mcmaier/hodor/hodor_hardware/mechanics/TSM-104-01-L-SH--3DModel-STEP-56544.STEP

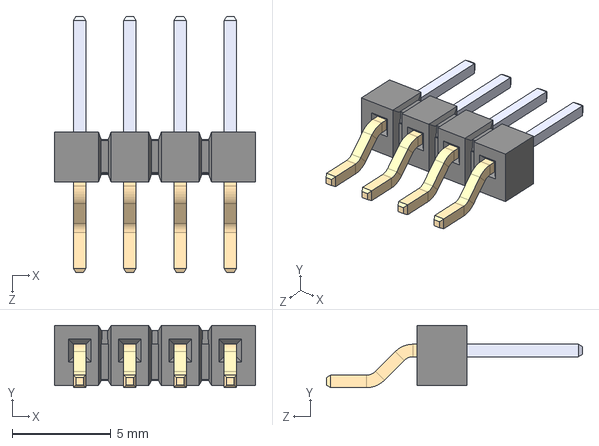
[picture p1: CAD file, 2025-02-26, last stored version]
hodor_hardware/mechanics/TSM-104-01-L-SH--3DModel-STEP-56544.STEP
10.2 x 3.15 x 13.0 mm
