mcmaier/hodor/hodor_hardware/mechanics/SSD1306_OLED.step

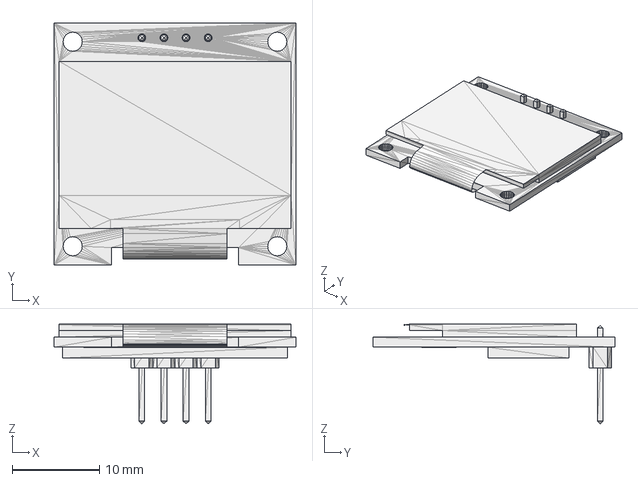
[picture p2: CAD file, 2025-02-26, last stored version]
hodor_hardware/mechanics/SSD1306_OLED.step
27.8 x 27.8 x 11.4 mm
