mcmaier/hodor/hodor_hardware/mechanics/449-340-55.STEP

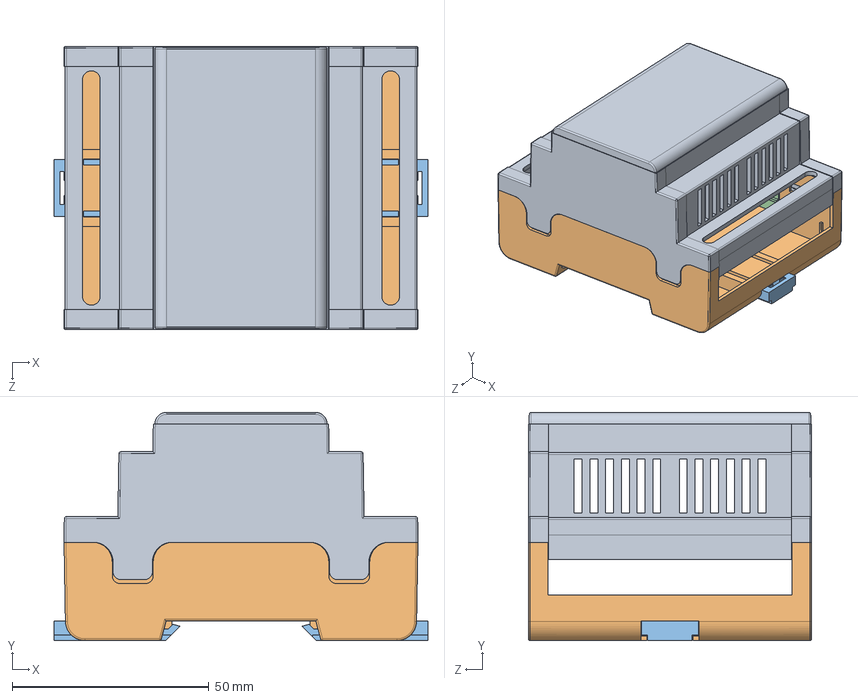
[picture p3: CAD file, 2025-02-26, last stored version]
hodor_hardware/mechanics/449-340-55.STEP
95.0 x 58.0 x 72.0 mm
044934056s
044934011s
044900300s x 2
044900400s x 2
