mcmaier/hodor/hodor_hardware/mechanics/SMH-104-02-G-S.stp

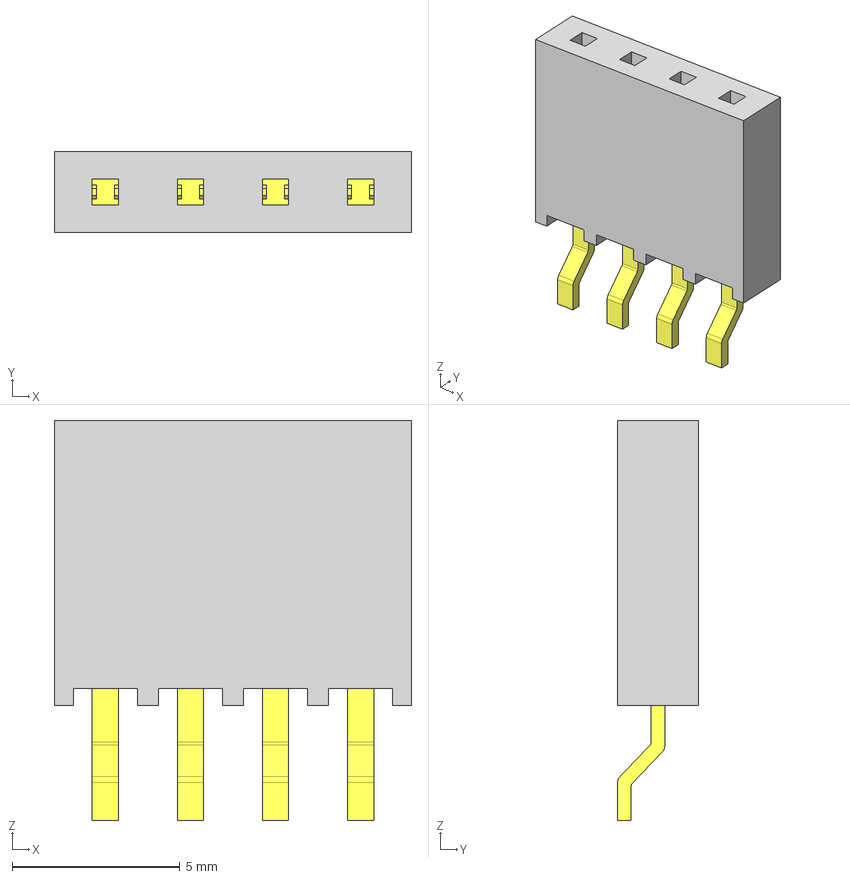
[picture p4: CAD file, 2025-02-26, last stored version]
hodor_hardware/mechanics/SMH-104-02-G-S.stp
10.7 x 2.41 x 11.9 mm
SMH-104-S_socket
C-08-03-04-S_SMH
