mcmaier/hodor/hodor_hardware/mechanics/apra_Rail_DB4.DXF

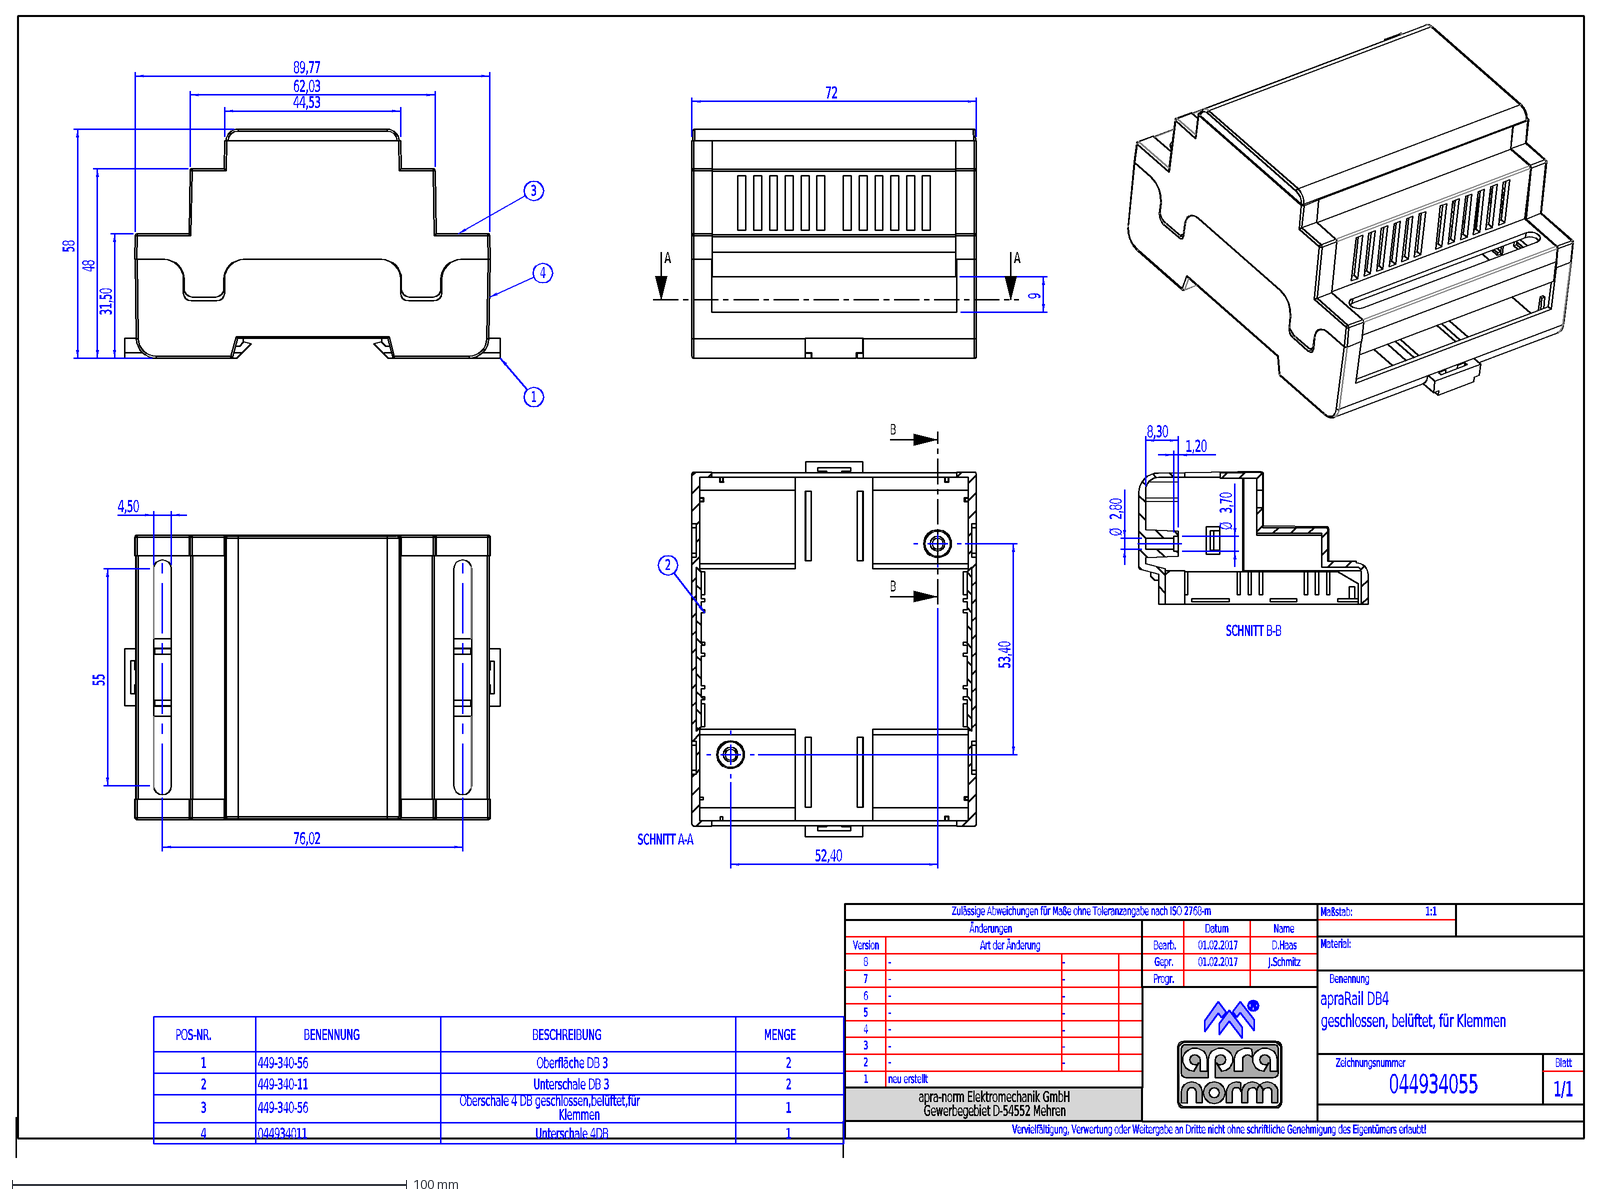
[picture p5: CAD file, 2025-02-26, last stored version]
hodor_hardware/mechanics/apra_Rail_DB4.DXF
-
1/1
044934055
geschlossen, belüftet, für Klemmen
apraRail DB4
01.02.2017
D.Haas
J.Schmitz
neu erstellt
Vervielfältigung, Verwertung oder Weitergabe an Dritte nicht ohne schriftliche Genehmigung des Eigentümers erlaubt!
Maßstab:
Material:
Benennung
Zeichnungsnummer
Blatt
Zulässige Abweichungen für Maße ohne Toleranzangabe nach ISO 2768-m
Name
Datum
Bearb.
Gepr.
Progr.
Änderungen
Art der Änderung
Version
8
7
4
5
6
1
2
3
apra-norm Elektromechanik GmbH
Gewerbegebiet D-54552 Mehren
1:1
POS-NR.
BENENNUNG
BESCHREIBUNG
MENGE
449-340-56
Oberfläche DB 3
449-340-11
Unterschale DB 3
Oberschale 4 DB geschlossen,belüftet,für
Klemmen
044934011
Unterschale 4DB
89,77
62,03
44,53
31,50
48
58
72
9
A
4,50
55
76,02
52,40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
