mcmaier/hodor/hodor_hardware/hodor_hardware.kicad_pcb

## KiCad design hodor_hardware/hodor_hardware.kicad_pcb (2025-03-13, last stored version)

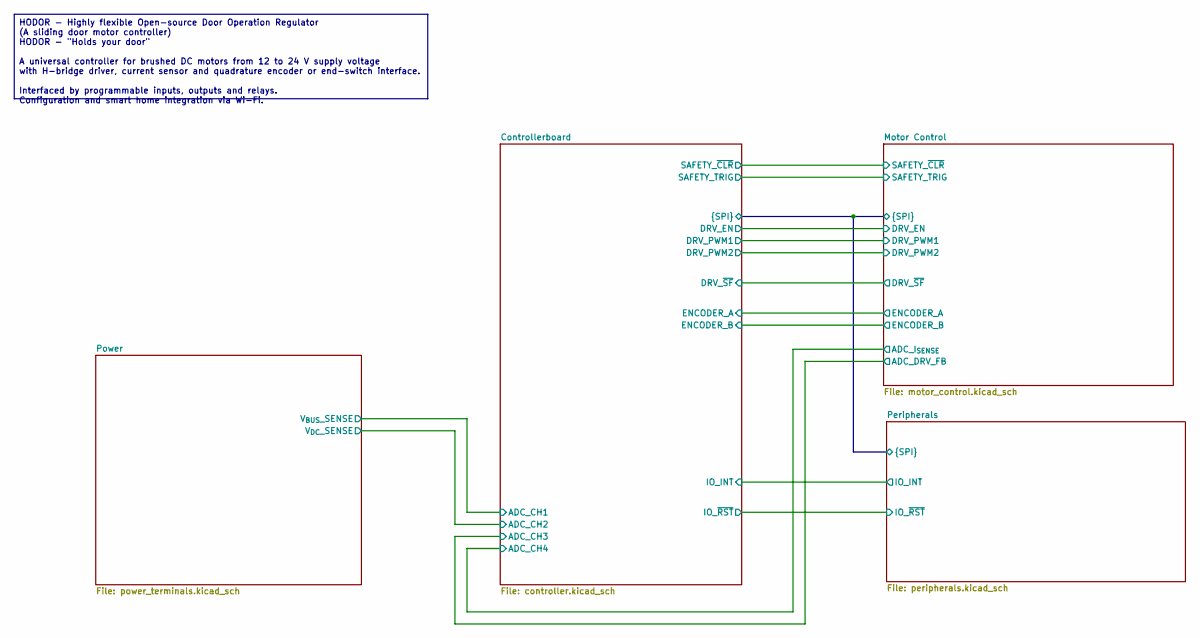
[picture p6: schematic hodor_hardware.kicad_sch, HODOR (Highly flexible Open-source Door Operation Regulator)]

Notes on the sheet:
HODOR - Highly flexible Open-source Door Operation Regulator (A sliding door motor controller) HODOR - "Holds your door" A universal controller for brushed DC motors from 12 to 24 V supply voltage with H-bridge driver, current sensor and quadrature encoder or end-switch interface. Interfaced by pro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

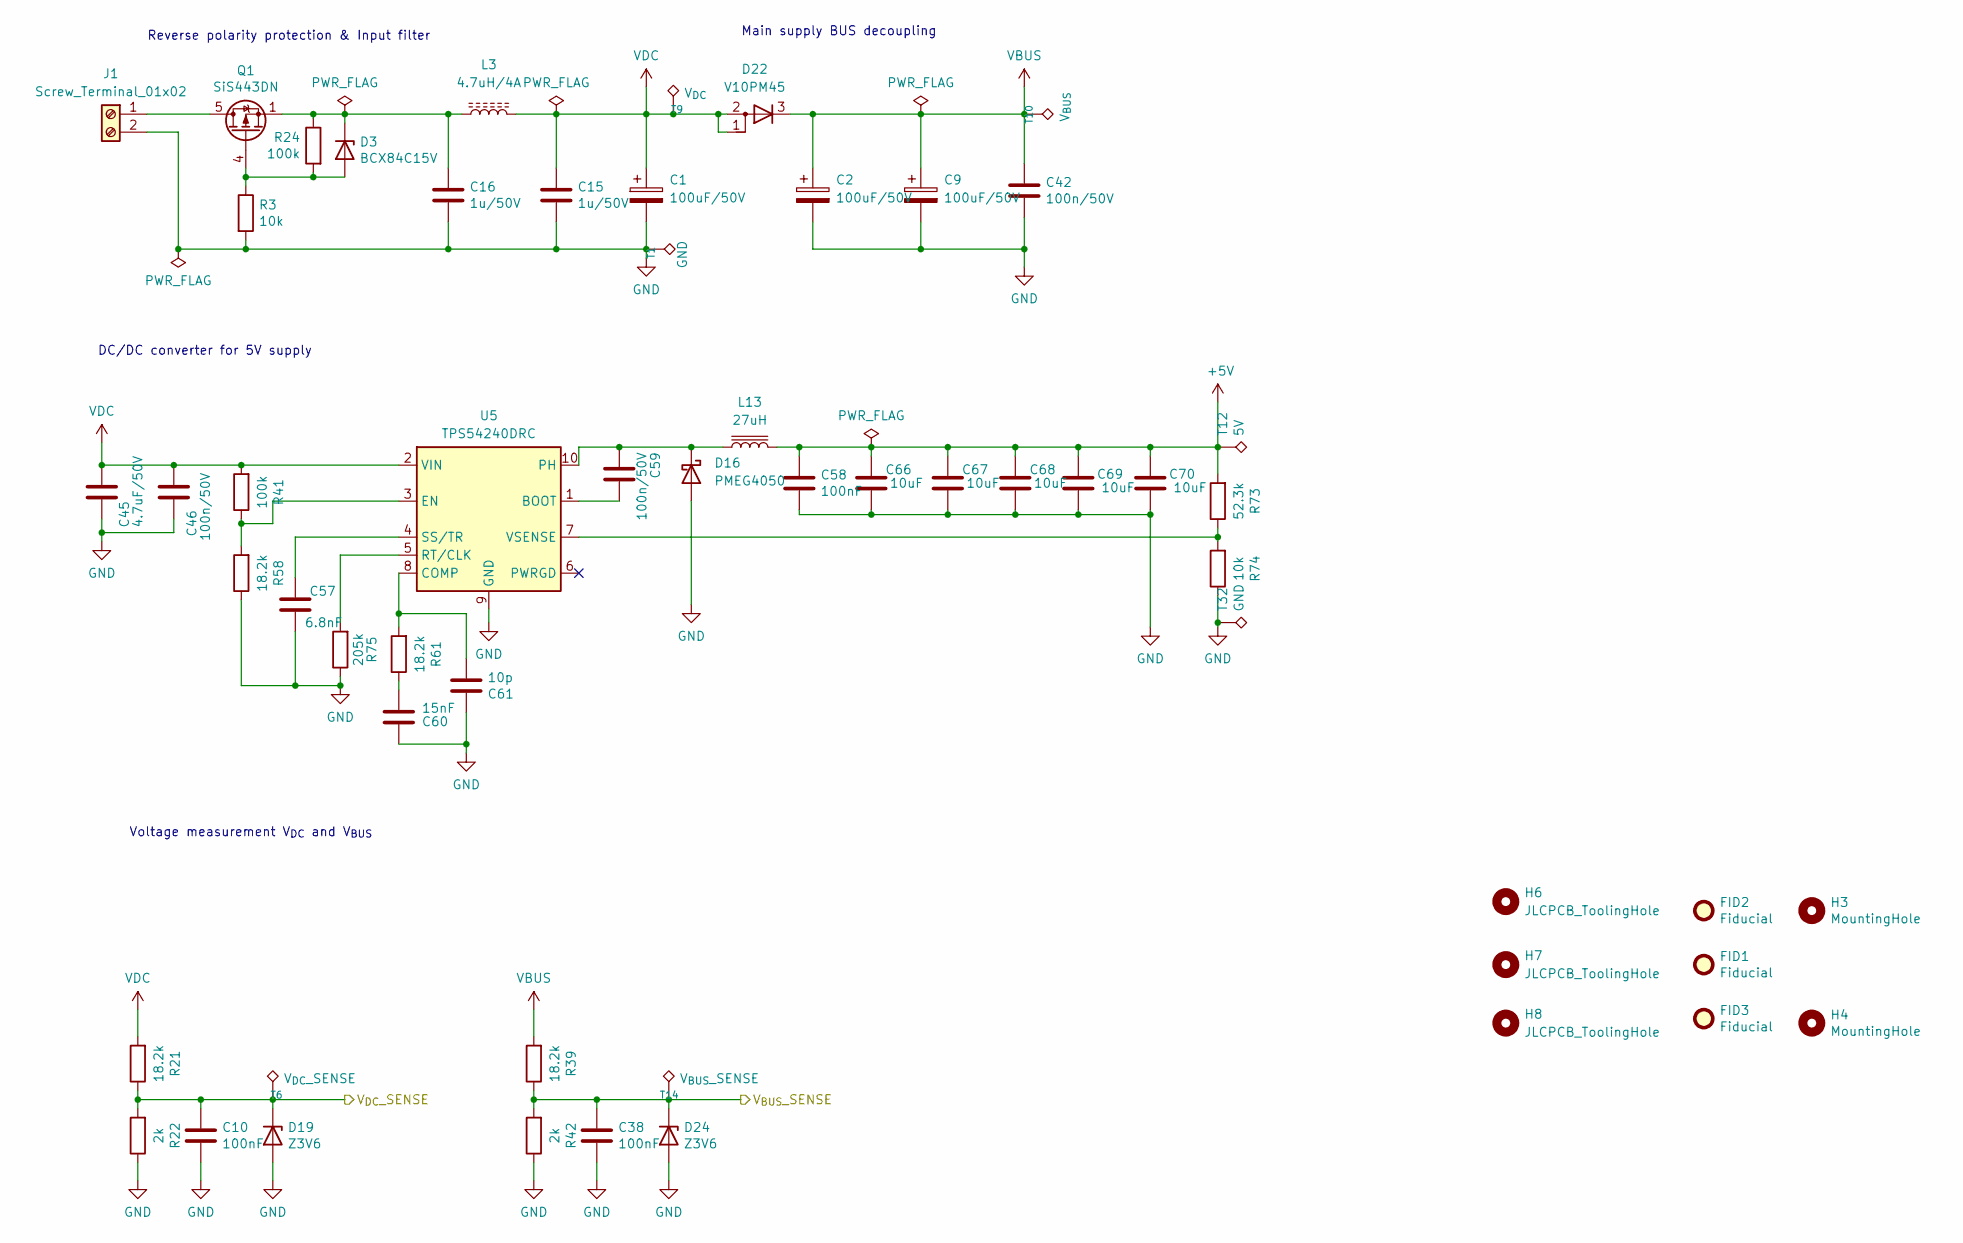
[picture p7: schematic power_terminals.kicad_sch, HODOR (Highly flexible Open-source Door Operation Regulator)]

Parts:
C1, C2, C9: 100uF/50V; C_Elec_8x10.2
C10, C38, C58: 100nF; C_0402_1005Metric
C15, C16: 1u/50V; C_0805_2012Metric
C42, C46, C59: 100n/50V; C_0603_1608Metric
C45: 4.7uF/50V; C_1206_3216Metric
C57: 6.8nF; C_0402_1005Metric
C60: 15nF; C_0402_1005Metric
C61: 10p; C_0402_1005Metric
C66, C67, C68, C69, C70: 10uF; C_0805_2012Metric
D3: BCX84C15V; D_SOD-523
D16: PMEG4050; D_SMB
D19, D24: Z3V6; D_SOD-523
D22: V10PM45; TO-277A
FID1, FID2, FID3: Fiducial; Fiducial_1mm_Mask2mm
H3, H4: MountingHole; MountingHole_3.2mm_M3
H6, H7, H8: JLCPCB_ToolingHole
J1: Screw_Terminal_01x02; TerminalBlock_Phoenix_MKDS-1,5-2_1x02_P5.00mm_Horizontal
L3: 4.7uH/4A; L_Wuerth_MAPI-4020
L13: 27uH; L_Wuerth_WE-PD-Typ-7345
Q1: SiS443DN; Vishay_PowerPAK_1212-8_Single
R3, R74: 10k; R_0402_1005Metric
R21, R39, R58, R61: 18.2k; R_0402_1005Metric
R22, R42: 2k; R_0402_1005Metric
R24, R41: 100k; R_0402_1005Metric
R73: 52.3k; R_0402_1005Metric
R75: 205k; R_0402_1005Metric
T1, T32: GND; TestPoint_Pad_1.0x1.0mm
T6: V_{DC}_SENSE; TestPoint_Pad_D1.0mm
T9: V_{DC}; TestPoint_Pad_D1.0mm
T10: V_{BUS}; TestPoint_Pad_D1.0mm
T12: 5V; TestPoint_Pad_D1.0mm
T14: V_{BUS}_SENSE; TestPoint_Pad_D1.0mm
U5: TPS54240DRC; Texas_DRC0010J_ThermalVias

Connections:
+5V: C58.1, C66.1, C67.1, C68.1, C69.1, C70.1, L13.2, R73.2, T12.1; also elsewhere on the board
/Controllerboard/ADC_CH1: C38.1, D24.1 (K), R39.1, R42.2, T14.1; also elsewhere on the board
/Controllerboard/ADC_CH2: C10.1, D19.1 (K), R21.1, R22.2, T6.1; also elsewhere on the board
GND: C1.2, C2.2, C9.2, C10.2, C15.2, C16.2, C38.2, C42.2, C45.2, C46.2, C57.2, C58.2, C60.1, C61.1, C66.2, C67.2, C68.2, C69.2, C70.2, D16.2 (A), D19.2 (A), D24.2 (A), J1.2, R3.2, R22.1, R42.1, R58.1, R74.1, R75.1, T1.1, T32.1, U5.9 (GND), U5.11 (GND); also elsewhere on the board
unnamed: C60.2, R61.1
unnamed: D3.2 (A), Q1.4 (G), R3.1, R24.2
unnamed: C16.1, D3.1 (K), L3.1, Q1.1 (S), Q1.2 (S), Q1.3 (S), R24.1
unnamed: C59.2, D16.1 (K), L13.1, U5.10 (PH)
unnamed: J1.1, Q1.5 (D)
unnamed: C59.1, U5.1 (BOOT)
unnamed: C61.2, R61.2, U5.8 (COMP)
unnamed: R41.1, R58.2, U5.3 (EN)
unnamed: R75.2, U5.5 (RT/CLK)
unnamed: C57.1, U5.4 (SS/TR)
unnamed: R73.1, R74.2, U5.7 (VSENSE)
VBUS: C2.1, C9.1, C42.1, D22.3 (K), R39.2, T10.1; also elsewhere on the board
VDC: C1.1, C15.1, C45.1, C46.1, D22.1 (A), D22.2 (A), L3.2, R21.2, R41.2, T9.1, U5.2 (VIN); also elsewhere on the board

Notes on the sheet:
DC/DC converter for 5V supply
Voltage measurement V_{DC} and V_{BUS}
Reverse polarity protection & Input filter
Main supply BUS decoupling

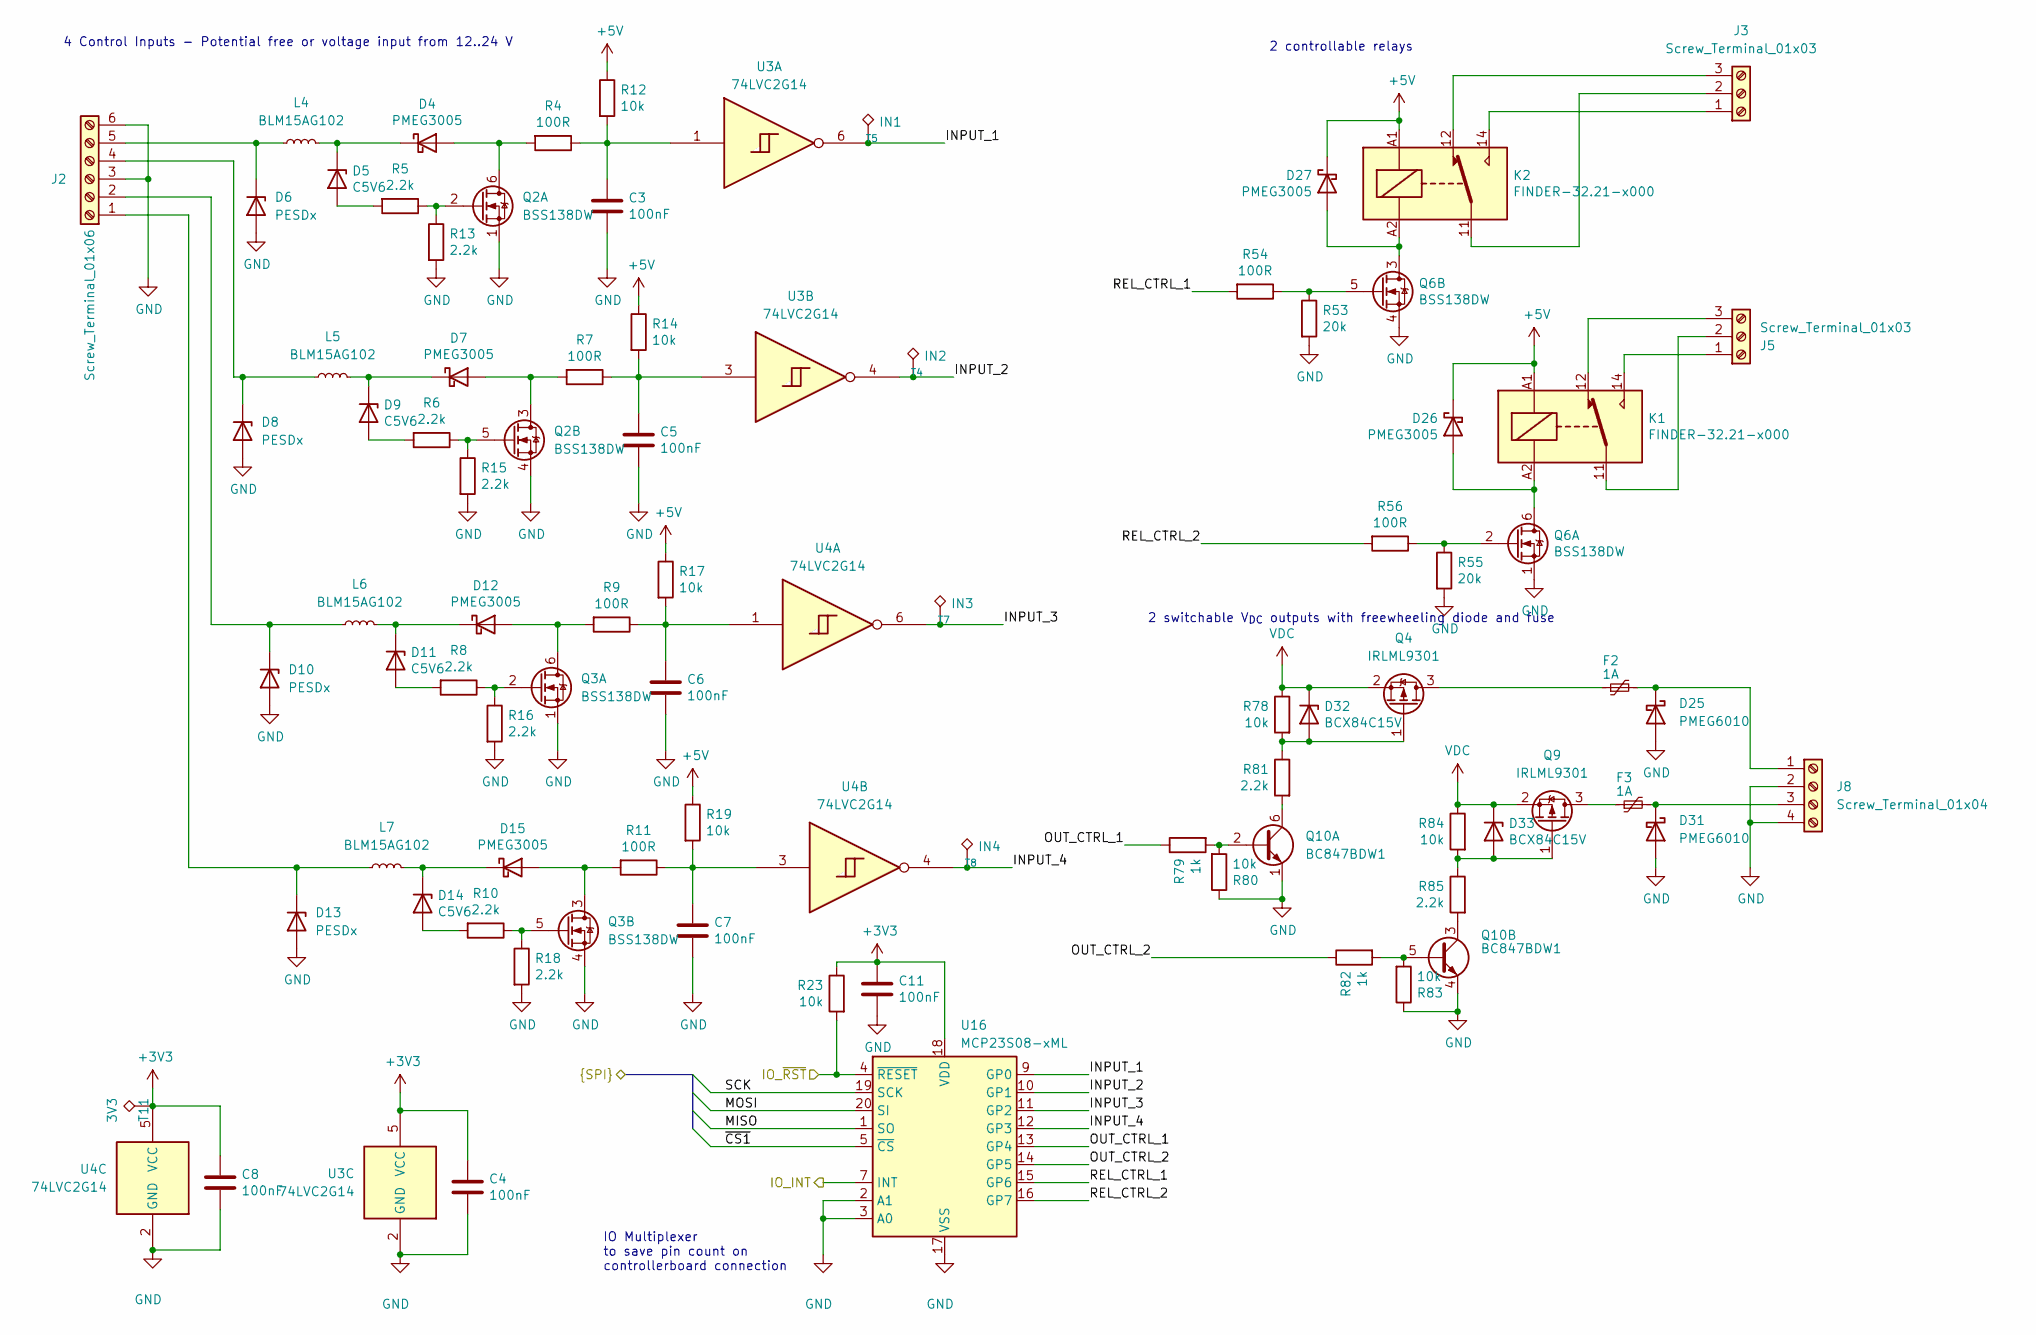
[picture p8: schematic peripherals.kicad_sch, HODOR (Highly flexible Open-source Door Operation Regulator)]

Parts:
C3, C4, C5, C6, C7, C8, C11: 100nF; C_0402_1005Metric
D4, D7, D12, D15, D26, D27: PMEG3005; D_SOD-523
D5, D9, D11, D14: C5V6; D_SOD-523
D6, D8, D10, D13: PESDx; D_SOD-523
D25, D31: PMEG6010; D_SOD-123F
D32, D33: BCX84C15V; D_SOD-523
F2, F3: 1A; Fuse_1210_3225Metric
J2: Screw_Terminal_01x06; TerminalBlock_Phoenix_MKDS-1,5-6_1x06_P5.00mm_Horizontal
J3, J5: Screw_Terminal_01x03; TerminalBlock_Phoenix_MKDS-1,5-3_1x03_P5.00mm_Horizontal
J8: Screw_Terminal_01x04; TerminalBlock_Phoenix_MKDS-1,5-4_1x04_P5.00mm_Horizontal
K1, K2: FINDER-32.21-x000; Relay_SPDT_Finder_32.21-x000
L4, L5, L6, L7: BLM15AG102; L_0402_1005Metric
Q2, Q3, Q6: BSS138DW; SOT-363_SC-70-6
Q4, Q9: IRLML9301; SOT-23
Q10: BC847BDW1; SOT-363_SC-70-6
R4, R7, R9, R11, R54, R56: 100R; R_0402_1005Metric
R5, R6, R8, R10, R13, R15, R16, R18, R81, R85: 2.2k; R_0402_1005Metric
R12, R14, R17, R19, R23, R78, R80, R83, R84: 10k; R_0402_1005Metric
R53, R55: 20k; R_0402_1005Metric
R79, R82: 1k; R_0402_1005Metric
T4: IN2; TestPoint_Pad_D1.0mm
T5: IN1; TestPoint_Pad_D1.0mm
T7: IN3; TestPoint_Pad_D1.0mm
T8: IN4; TestPoint_Pad_D1.0mm
T11: 3V3; TestPoint_Pad_D1.0mm
U3, U4: 74LVC2G14; SOT-23-6
U16: MCP23S08-xML; QFN-20-1EP_4x4mm_P0.5mm_EP2.7x2.7mm

Connections:
+3V3: C4.1, C8.1, C11.1, R23.1, T11.1, U3.5 (VCC), U4.5 (VCC), U16.18 (VDD); also elsewhere on the board
+5V: D26.1 (K), D27.1 (K), K1.A1, K2.A1, R12.1, R14.1, R17.1, R19.1; also elsewhere on the board
/Controllerboard/IO_INT: U16.7 (INT); also elsewhere on the board
/Controllerboard/IO_~RST: R23.2, U16.4 (~RESET); also elsewhere on the board
/Controllerboard/MISO: U16.1 (SO); also elsewhere on the board
/Controllerboard/MOSI: U16.20 (SI); also elsewhere on the board
/Controllerboard/SCK: U16.19 (SCK); also elsewhere on the board
/Controllerboard/~CS1: U16.5 (~CS); also elsewhere on the board
/Peripherals/INPUT_1: T5.1, U3.6, U16.9 (GP0)
/Peripherals/INPUT_2: T4.1, U3.4, U16.10 (GP1)
/Peripherals/INPUT_3: T7.1, U4.6, U16.11 (GP2)
/Peripherals/INPUT_4: T8.1, U4.4, U16.12 (GP3)
/Peripherals/OUT_CTRL_1: R79.1, U16.13 (GP4)
/Peripherals/OUT_CTRL_2: R82.1, U16.14 (GP5)
/Peripherals/REL_CTRL_1: R54.2, U16.15 (GP6)
/Peripherals/REL_CTRL_2: R56.2, U16.16 (GP7)
GND: C3.2, C4.2, C5.2, C6.2, C7.2, C8.2, C11.2, D6.2 (A), D8.2 (A), D10.2 (A), D13.2 (A), D25.2 (A), D31.2 (A), J2.3, J2.6, J8.2, J8.4, Q2.1 (S), Q2.4 (S), Q3.1 (S), Q3.4 (S), Q6.1 (S), Q6.4 (S), Q10.1 (E1), Q10.4 (E2), R13.2, R15.2, R16.2, R18.2, R53.2, R55.2, R80.1, R83.1, U3.2 (GND), U4.2 (GND), U16.2 (A1), U16.3 (A0), U16.17 (VSS); also elsewhere on the board
unnamed: C3.1, R4.1, R12.2, U3.1
unnamed: C5.1, R7.1, R14.2, U3.3
unnamed: C6.1, R9.1, R17.2, U4.1
unnamed: C7.1, R11.1, R19.2, U4.3
unnamed: D4.2 (A), Q2.6 (D), R4.2
unnamed: D4.1 (K), D5.1 (K), L4.2
unnamed: D5.2 (A), R5.2
unnamed: D6.1 (K), J2.5, L4.1
unnamed: D7.2 (A), Q2.3 (D), R7.2
unnamed: D7.1 (K), D9.1 (K), L5.2
unnamed: D8.1 (K), J2.4, L5.1
unnamed: D9.2 (A), R6.2
unnamed: D10.1 (K), J2.2, L6.1
unnamed: D11.2 (A), R8.2
unnamed: D11.1 (K), D12.1 (K), L6.2
unnamed: D12.2 (A), Q3.6 (D), R9.2
unnamed: D13.1 (K), J2.1, L7.1
unnamed: D14.2 (A), R10.2
unnamed: D14.1 (K), D15.1 (K), L7.2
unnamed: D15.2 (A), Q3.3 (D), R11.2
unnamed: D25.1 (K), F2.2, J8.1
unnamed: D26.2 (A), K1.A2, Q6.6 (D)
unnamed: D27.2 (A), K2.A2, Q6.3 (D)
unnamed: D31.1 (K), F3.2, J8.3
unnamed: D32.2 (A), Q4.1 (G), R78.2, R81.1
unnamed: D33.2 (A), Q9.1 (G), R84.2, R85.1
unnamed: J3.1, K2.14
unnamed: J3.2, K2.11
unnamed: J3.3, K2.12
unnamed: J5.1, K1.14
unnamed: J5.2, K1.11
unnamed: J5.3, K1.12
unnamed: Q2.2 (G), R5.1, R13.1
unnamed: Q2.5 (G), R6.1, R15.1
unnamed: Q3.2 (G), R8.1, R16.1
unnamed: Q3.5 (G), R10.1, R18.1
unnamed: F2.1, Q4.3 (D)
unnamed: Q6.2 (G), R55.1, R56.1
unnamed: Q6.5 (G), R53.1, R54.1
unnamed: F3.1, Q9.3 (D)
unnamed: Q10.2 (B1), R79.2, R80.2
unnamed: Q10.6 (C1), R81.2
unnamed: Q10.5 (B2), R82.2, R83.2
unnamed: Q10.3 (C2), R85.2
VDC: D32.1 (K), D33.1 (K), Q4.2 (S), Q9.2 (S), R78.1, R84.1; also elsewhere on the board

Notes on the sheet:
4 Control Inputs - Potential free or voltage input from 12..24 V
2 controllable relays
2 switchable V_{DC} outputs with freewheeling diode and fuse
IO Multiplexer to save pin count on controllerboard connection

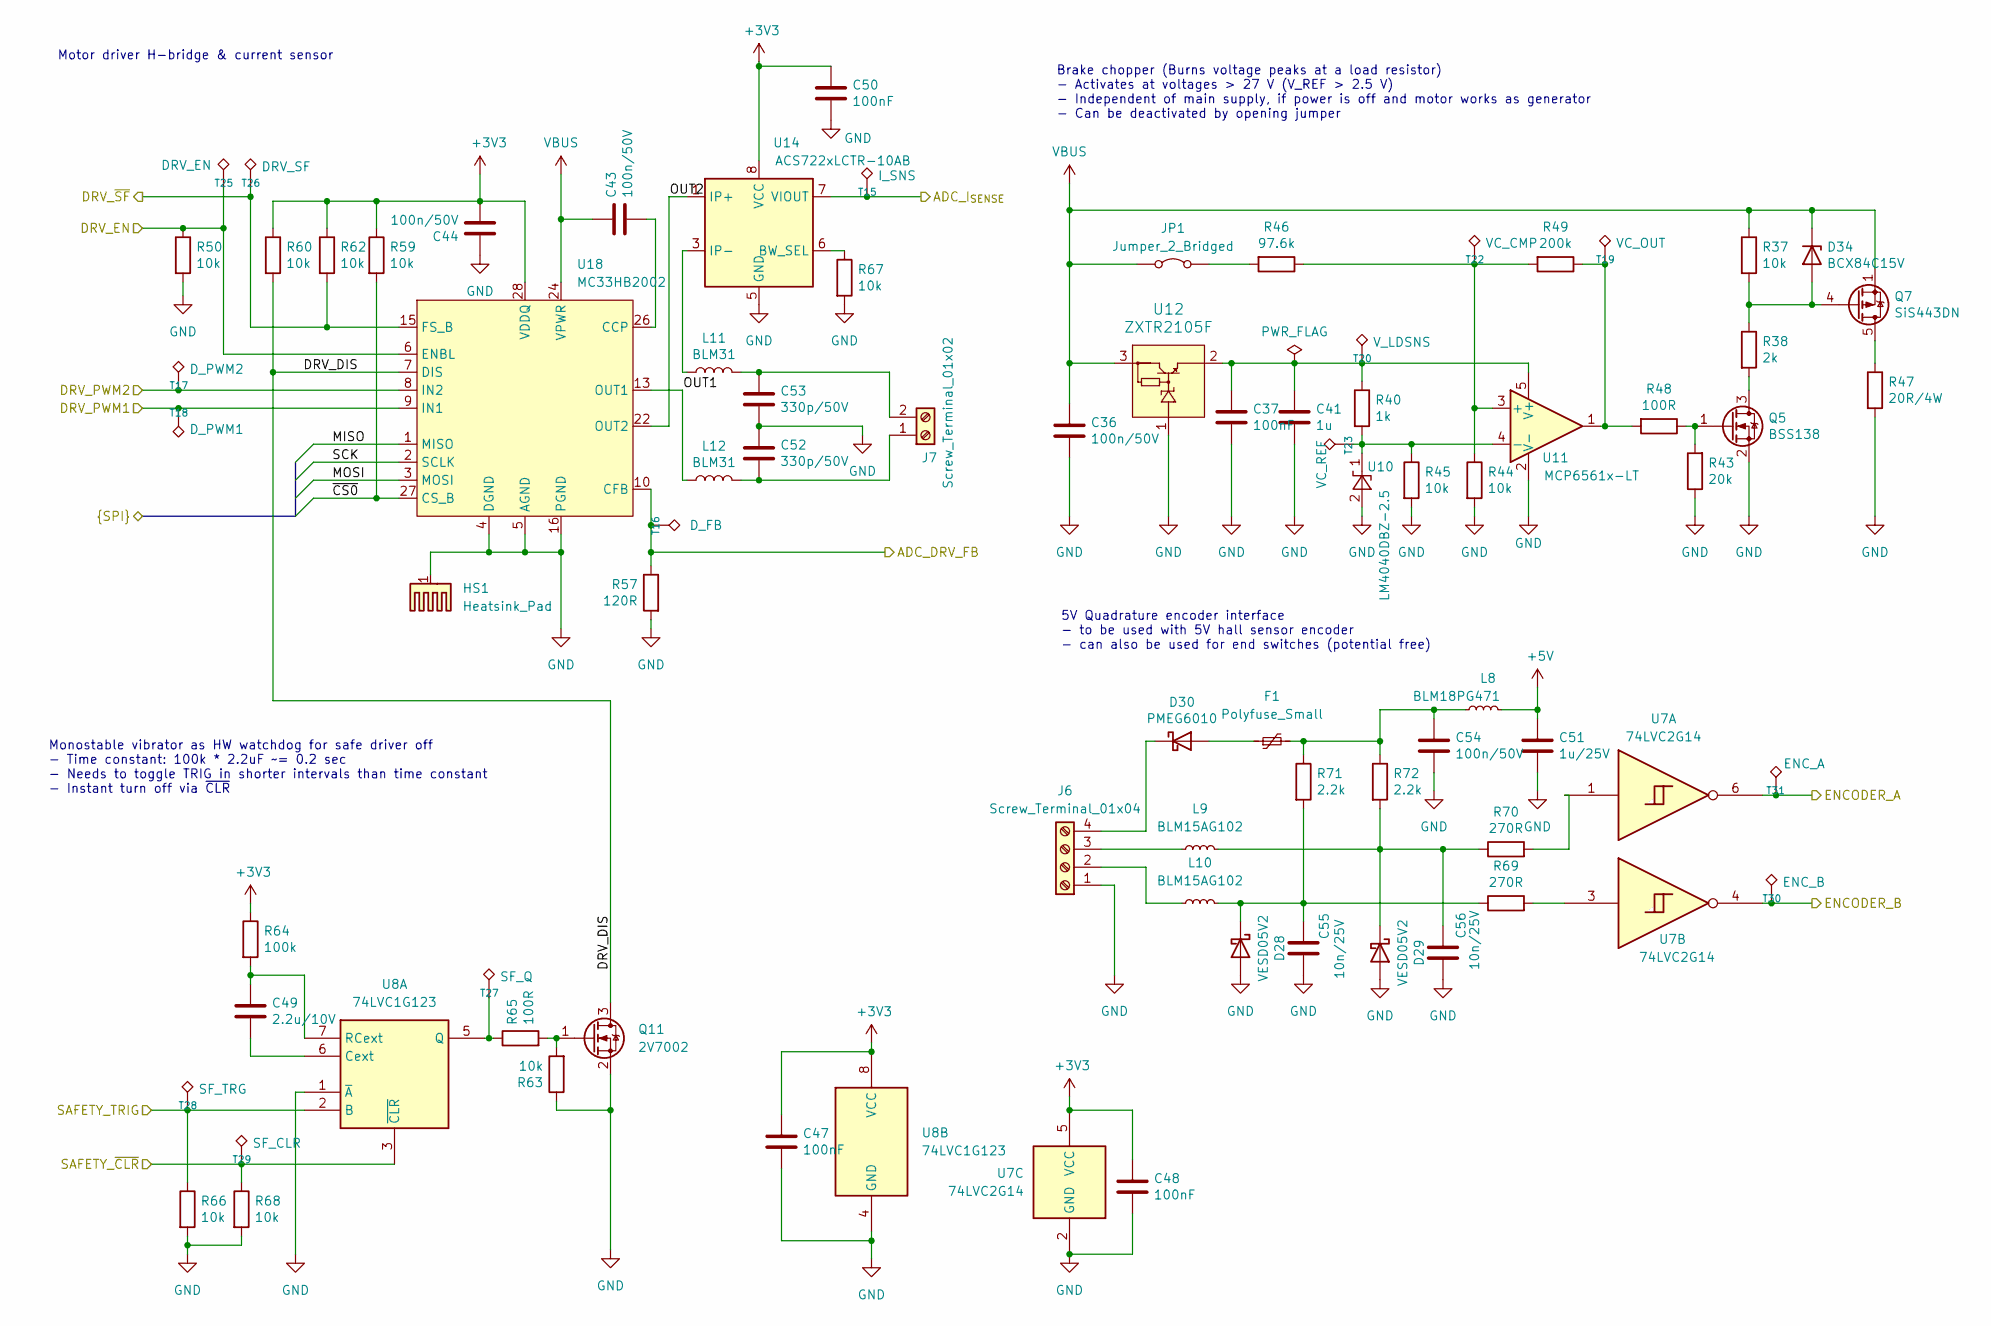
[picture p9: schematic motor_control.kicad_sch, HODOR (Highly flexible Open-source Door Operation Regulator)]

Parts:
C36, C43, C44, C54: 100n/50V; C_0603_1608Metric
C37, C47, C48, C50: 100nF; C_0402_1005Metric
C41: 1u; C_0402_1005Metric
C49: 2.2u/10V; C_0603_1608Metric
C51: 1u/25V; C_0603_1608Metric
C52, C53: 330p/50V; C_0603_1608Metric
C55, C56: 10n/25V; C_0402_1005Metric
D28, D29: VESD05V2; D_SOD-523
D30: PMEG6010; D_SOD-123F
D34: BCX84C15V; D_SOD-523
F1: Polyfuse_Small; Fuse_0805_2012Metric
HS1: Heatsink_Pad; Heatsink_AAVID_573300D00010G_TO-263
J6: Screw_Terminal_01x04; TerminalBlock_Phoenix_MKDS-1,5-4_1x04_P5.00mm_Horizontal
J7: Screw_Terminal_01x02; TerminalBlock_Phoenix_MKDS-1,5-2_1x02_P5.00mm_Horizontal
JP1: Jumper_2_Bridged; SolderJumper-2_P1.3mm_Bridged_Pad1.0x1.5mm
L8: BLM18PG471; L_0603_1608Metric
L9, L10: BLM15AG102; L_0402_1005Metric
L11, L12: BLM31; L_1206_3216Metric
Q5: BSS138; SOT-23
Q7: SiS443DN; Vishay_PowerPAK_1212-8_Single
Q11: 2V7002; SOT-323_SC-70
R37, R44, R45, R50, R59, R60, R62, R63, R66, R67, R68: 10k; R_0402_1005Metric
R38: 2k; R_0805_2012Metric
R40: 1k; R_0402_1005Metric
R43: 20k; R_0402_1005Metric
R46: 97.6k; R_0402_1005Metric
R47: 20R/4W; R_2816_7142Metric
R48, R65: 100R; R_0402_1005Metric
R49: 200k; R_0402_1005Metric
R57: 120R; R_0603_1608Metric
R64: 100k; R_0402_1005Metric
R69, R70: 270R; R_0402_1005Metric
R71, R72: 2.2k; R_0402_1005Metric
T15: I_SNS; TestPoint_Pad_D1.0mm
T16: D_FB; TestPoint_Pad_D1.0mm
T17: D_PWM2; TestPoint_Pad_D1.0mm
T18: D_PWM1; TestPoint_Pad_D1.0mm
T19: VC_OUT; TestPoint_Pad_D1.0mm
T20: V_LDSNS; TestPoint_Pad_D1.0mm
T22: VC_CMP; TestPoint_Pad_D1.0mm
T23: VC_REF; TestPoint_Pad_D1.0mm
T25: DRV_EN; TestPoint_Pad_D1.0mm
T26: DRV_SF; TestPoint_Pad_D1.0mm
T27: SF_Q; TestPoint_Pad_D1.0mm
T28: SF_TRG; TestPoint_Pad_D1.0mm
T29: SF_CLR; TestPoint_Pad_D1.0mm
T30: ENC_B; TestPoint_Pad_D1.0mm
T31: ENC_A; TestPoint_Pad_D1.0mm
U7: 74LVC2G14; SOT-23-6
U8: 74LVC1G123; VSSOP-8_2.3x2mm_P0.5mm
U10: LM4040DBZ-2.5; SOT-23
U11: MCP6561x-LT; SOT-353_SC-70-5
U12: ZXTR2105F; SOT-23
U14: ACS722xLCTR-10AB; SOIC-8_3.9x4.9mm_P1.27mm
U18: MC33HB2002; HVQFN-28-1EP_6x6mm_MC33HB2002

Connections:
+3V3: C44.2, C47.1, C48.1, C50.1, R59.1, R60.1, R62.1, R64.1, U7.5 (VCC), U8.8 (VCC), U14.8 (VCC), U18.28 (VDDQ); also elsewhere on the board
+5V: C51.1, L8.2; also elsewhere on the board
/Controllerboard/ADC_CH3: R57.1, T16.1, U18.10 (CFB); also elsewhere on the board
/Controllerboard/ADC_CH4: T15.1, U14.7 (VIOUT); also elsewhere on the board
/Controllerboard/DRV_EN: R50.1, T25.1, U18.6 (ENBL); also elsewhere on the board
/Controllerboard/DRV_PWM1: T18.1, U18.9 (IN1); also elsewhere on the board
/Controllerboard/DRV_PWM2: T17.1, U18.8 (IN2); also elsewhere on the board
/Controllerboard/DRV_~SF: R62.2, T26.1, U18.15 (FS_B); also elsewhere on the board
/Controllerboard/ENCODER_A: T31.1, U7.6; also elsewhere on the board
/Controllerboard/ENCODER_B: T30.1, U7.4; also elsewhere on the board
/Controllerboard/MISO: U18.1 (MISO); also elsewhere on the board
/Controllerboard/MOSI: U18.3 (MOSI); also elsewhere on the board
/Controllerboard/SAFETY_TRIG: R66.1, T28.1, U8.2 (B); also elsewhere on the board
/Controllerboard/SAFETY_~CLR: R68.1, T29.1, U8.3 (~CLR); also elsewhere on the board
/Controllerboard/SCK: U18.2 (SCLK); also elsewhere on the board
/Controllerboard/~CS0: R59.2, U18.27 (CS_B); also elsewhere on the board
/Motor Control/DRV_DIS: Q11.3 (D), R60.2, U18.7 (DIS)
/Motor Control/OUT1: L12.1, U18.13 (OUT1), U18.14 (OUT1)
/Motor Control/OUT2: U14.1 (IP+), U14.2 (IP+), U18.22 (OUT2), U18.23 (OUT2)
GND: C36.2, C37.2, C41.2, C44.1, C47.2, C48.2, C50.2, C51.2, C52.1, C53.2, C54.2, C55.2, C56.2, D28.2 (A), D29.2 (A), HS1.1, J6.1, Q5.2 (S), Q11.2 (S), R43.1, R44.2, R45.2, R47.2, R50.2, R57.2, R63.1, R66.2, R67.2, R68.2, U7.2 (GND), U8.1 (~A), U8.4 (GND), U10.2 (A), U11.2 (V-), U12.1 (GND), U14.5 (GND), U18.4 (DGND), U18.5 (AGND), U18.16 (PGND), U18.17 (PGND), U18.18 (PGND), U18.19 (PGND), U18.20 (PGND), U18.21 (AGND), U18.29 (AGND); also elsewhere on the board
unnamed: C54.1, F1.2, L8.1, R71.1, R72.1
unnamed: C55.1, D28.1 (K), L10.2, R69.1, R71.2
unnamed: C56.1, D29.1 (K), L9.2, R70.1, R72.2
unnamed: D30.2 (A), F1.1
unnamed: D30.1 (K), J6.4
unnamed: D34.2 (A), Q7.4 (G), R37.2, R38.1
unnamed: J6.2, L10.1
unnamed: J6.3, L9.1
unnamed: C52.2, J7.1, L12.2
unnamed: C53.1, J7.2, L11.2
unnamed: JP1.2 (B), R46.2
unnamed: L11.1, U14.3 (IP-), U14.4 (IP-)
unnamed: Q5.3 (D), R38.2
unnamed: Q5.1 (G), R43.2, R48.1
unnamed: Q7.5 (D), R47.1
unnamed: Q11.1 (G), R63.2, R65.2
unnamed: R48.2, R49.1, T19.1, U11.1
unnamed: R69.2, U7.3
unnamed: R70.2, U7.1
unnamed: C49.2, U8.6 (Cext)
unnamed: R65.1, T27.1, U8.5 (Q)
unnamed: C49.1, R64.2, U8.7 (RCext)
unnamed: R40.2, R45.1, T23.1, U10.1 (K), U11.4 (-)
unnamed: R44.1, R46.1, R49.2, T22.1, U11.3 (+)
unnamed: C37.1, C41.1, R40.1, T20.1, U11.5 (V+), U12.2 (VOUT)
unnamed: R67.1, U14.6 (BW_SEL)
unnamed: C43.2, U18.26 (CCP)
VBUS: C36.1, C43.1, D34.1 (K), JP1.1 (A), Q7.1 (S), Q7.2 (S), Q7.3 (S), R37.1, U12.3 (VIN), U18.11 (VPWR), U18.12 (VPWR), U18.24 (VPWR), U18.25 (VPWR); also elsewhere on the board

Notes on the sheet:
Brake chopper (Burns voltage peaks at a load resistor) - Activates at voltages > 27 V (V_REF > 2.5 V) - Independent of main supply, if power is off and motor works as generator - Can be deactivated by opening jumper
5V Quadrature encoder interface - to be used with 5V hall sensor encoder - can also be used for end switches (potential free)
Motor driver H-bridge & current sensor
Monostable vibrator as HW watchdog for safe driver off - Time constant: 100k * 2.2uF ~= 0.2 sec - Needs to toggle TRIG in shorter intervals than time constant - Instant turn off via ~{CLR}

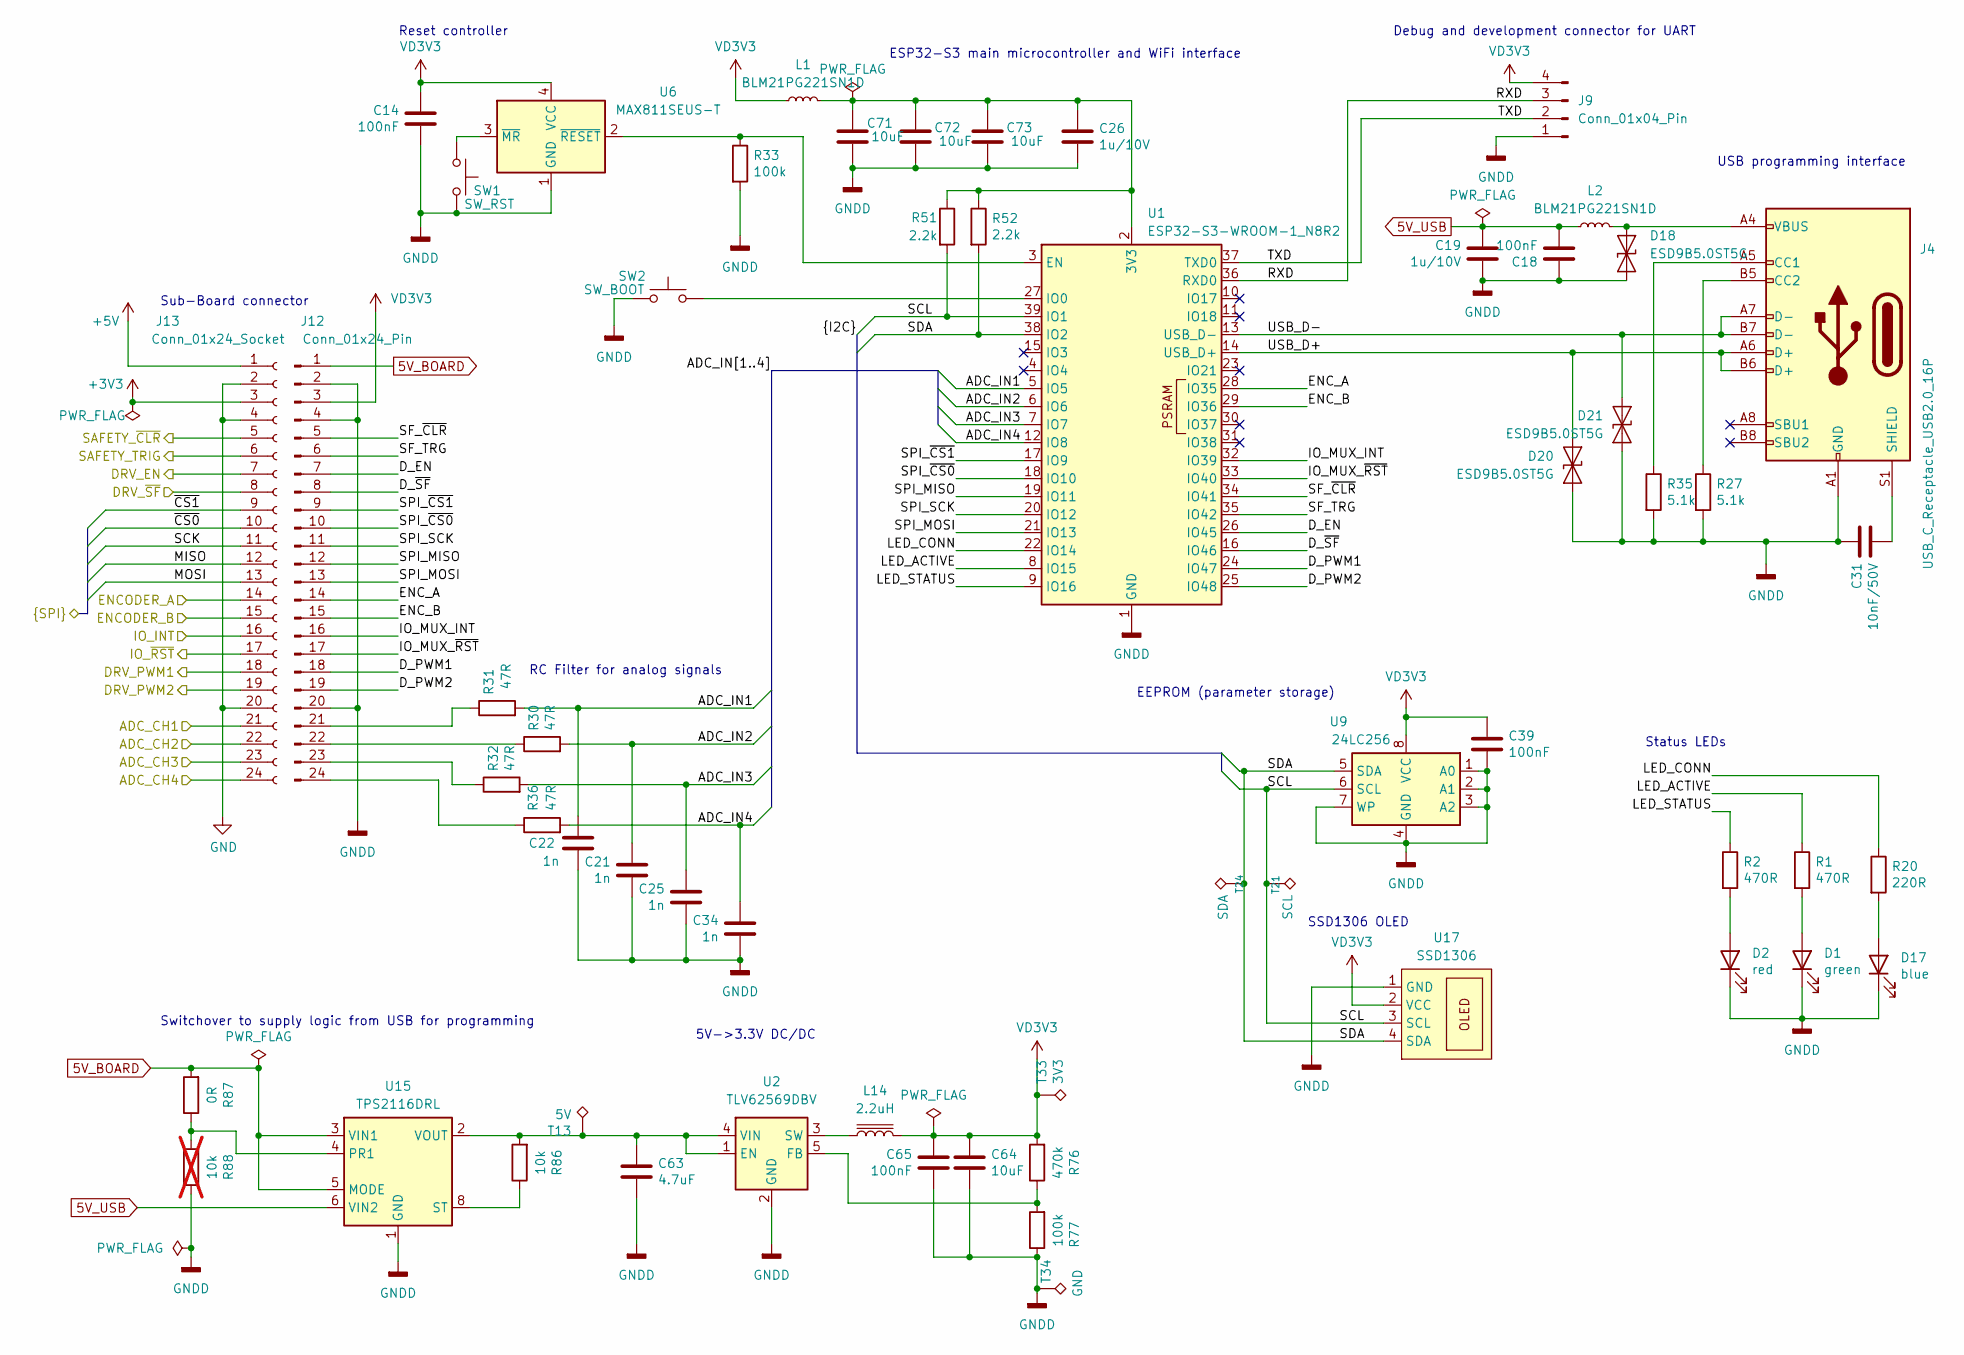
[picture p10: schematic controller.kicad_sch, HODOR (Highly flexible Open-source Door Operation Regulator)]

Parts:
C14, C18, C39, C65: 100nF; C_0402_1005Metric
C19, C26: 1u/10V; C_0402_1005Metric
C21, C22, C25, C34: 1n; C_0402_1005Metric
C31: 10nF/50V; C_0402_1005Metric
C63: 4.7uF; C_1206_3216Metric
C64, C71, C72, C73: 10uF; C_0805_2012Metric
D1: green; LED_Kingbright_APA1606_1.6x0.6mm_Horizontal
D2: red; LED_Kingbright_APA1606_1.6x0.6mm_Horizontal
D17: blue; LED_Kingbright_APA1606_1.6x0.6mm_Horizontal
D18, D20, D21: ESD9B5.0ST5G; D_SOD-923
J4: USB_C_Receptacle_USB2.0_16P; USB_C_Receptacle_G-Switch_GT-USB-7010ASV
J9: Conn_01x04_Pin; Conn_Header2.54_1x04_SMD
J12: Conn_01x24_Pin; PinHeader_2x12_P2.00mm_Horizontal
J13: Conn_01x24_Socket; PinSocket_2x12_P2.00mm_Vertical
L1, L2: BLM21PG221SN1D; L_0805_2012Metric
L14: 2.2uH; L_1812_4532Metric
R1, R2: 470R; R_0402_1005Metric
R20: 220R; R_0402_1005Metric
R27, R35: 5.1k; R_0402_1005Metric
R30, R31, R32, R36: 47R; R_0402_1005Metric
R33, R77: 100k; R_0402_1005Metric
R51, R52: 2.2k; R_0402_1005Metric
R76: 470k; R_0402_1005Metric
R86: 10k; R_0402_1005Metric
R87: 0R; R_0402_1005Metric
R88: 10k; R_0402_1005Metric; not fitted
SW1: SW_RST; SW_SPST_CK_KMS2xxG
SW2: SW_BOOT; SW_SPST_CK_KMS2xxG
T13: 5V; TestPoint_Pad_D1.0mm
T21: SCL; TestPoint_Pad_D1.0mm
T24: SDA; TestPoint_Pad_D1.0mm
T33: 3V3; TestPoint_Pad_D1.0mm
T34: GND; TestPoint_Pad_1.0x1.0mm
U1: ESP32-S3-WROOM-1_N8R2; ESP32-S3-WROOM-1
U2: TLV62569DBV; SOT-23-5
U6: MAX811SEUS-T; SOT-143
U9: 24LC256; TSSOP-8_4.4x3mm_P0.65mm
U15: TPS2116DRL; SOT-583-8
U17: SSD1306; SSD1306_OLED_Horizontal_Reverse

Connections:
5V_BOARD: J12.1, R87.2, U15.3 (VIN1), U15.5 (MODE)
5V_USB: C18.1, C19.2, L2.1, U15.6 (VIN2)
+3V3: J13.3; also elsewhere on the board
+5V: J13.1; also elsewhere on the board
/Controllerboard/ADC_CH1: J13.21; also elsewhere on the board
/Controllerboard/ADC_CH2: J13.22; also elsewhere on the board
/Controllerboard/ADC_CH3: J13.23; also elsewhere on the board
/Controllerboard/ADC_CH4: J13.24; also elsewhere on the board
/Controllerboard/ADC_IN1: C22.2, R31.2, U1.5 (IO5)
/Controllerboard/ADC_IN2: C21.2, R30.2, U1.6 (IO6)
/Controllerboard/ADC_IN3: C25.2, R32.2, U1.7 (IO7)
/Controllerboard/ADC_IN4: C34.2, R36.2, U1.12 (IO8)
/Controllerboard/DRV_EN: J13.7; also elsewhere on the board
/Controllerboard/DRV_PWM1: J13.18; also elsewhere on the board
/Controllerboard/DRV_PWM2: J13.19; also elsewhere on the board
/Controllerboard/DRV_~SF: J13.8; also elsewhere on the board
/Controllerboard/D_EN: J12.7, U1.26 (IO45)
/Controllerboard/D_PWM1: J12.18, U1.24 (IO47)
/Controllerboard/D_PWM2: J12.19, U1.25 (IO48)
/Controllerboard/D_~SF: J12.8, U1.16 (IO46)
/Controllerboard/ENCODER_A: J13.14; also elsewhere on the board
/Controllerboard/ENCODER_B: J13.15; also elsewhere on the board
/Controllerboard/ENC_A: J12.14, U1.28 (IO35)
/Controllerboard/ENC_B: J12.15, U1.29 (IO36)
/Controllerboard/IO_INT: J13.16; also elsewhere on the board
/Controllerboard/IO_MUX_INT: J12.16, U1.32 (IO39)
/Controllerboard/IO_MUX_~RST: J12.17, U1.33 (IO40)
/Controllerboard/IO_~RST: J13.17; also elsewhere on the board
/Controllerboard/LED_ACTIVE: R1.1, U1.8 (IO15)
/Controllerboard/LED_CONN: R20.1, U1.22 (IO14)
/Controllerboard/LED_STATUS: R2.1, U1.9 (IO16)
/Controllerboard/MISO: J13.12; also elsewhere on the board
/Controllerboard/MOSI: J13.13; also elsewhere on the board
/Controllerboard/RXD: J9.3, U1.36 (RXD0)
/Controllerboard/SAFETY_TRIG: J13.6; also elsewhere on the board
/Controllerboard/SAFETY_~CLR: J13.5; also elsewhere on the board
/Controllerboard/SCK: J13.11; also elsewhere on the board
/Controllerboard/SCL: R51.2, T21.1, U1.39 (IO1), U9.6 (SCL), U17.3 (SCL)
/Controllerboard/SDA: R52.2, T24.1, U1.38 (IO2), U9.5 (SDA), U17.4 (SDA)
/Controllerboard/SF_TRG: J12.6, U1.35 (IO42)
/Controllerboard/SF_~CLR: J12.5, U1.34 (IO41)
/Controllerboard/SPI_MISO: J12.12, U1.19 (IO11)
/Controllerboard/SPI_MOSI: J12.13, U1.21 (IO13)
/Controllerboard/SPI_SCK: J12.11, U1.20 (IO12)
/Controllerboard/SPI_~CS0: J12.10, U1.18 (IO10)
/Controllerboard/SPI_~CS1: J12.9, U1.17 (IO9)
/Controllerboard/TXD: J9.2, U1.37 (TXD0)
/Controllerboard/USB_D+: D20.2 (A2), J4.A6 (D+), J4.B6 (D+), U1.14 (USB_D+)
/Controllerboard/USB_D-: D21.2 (A2), J4.A7 (D-), J4.B7 (D-), U1.13 (USB_D-)
/Controllerboard/~CS0: J13.10; also elsewhere on the board
/Controllerboard/~CS1: J13.9; also elsewhere on the board
GND: J13.2, J13.4, J13.20; also elsewhere on the board
GNDD: C14.1, C18.2, C19.1, C21.1, C22.1, C25.1, C26.1, C31.2, C34.1, C39.1, C63.2, C64.2, C65.2, C71.2, C72.2, C73.2, D1.1 (K), D2.1 (K), D17.1 (K), D18.1 (A1), D20.1 (A1), D21.1 (A1), J4.A1 (GND), J4.A12 (GND), J4.B1 (GND), J4.B12 (GND), J9.1, J12.2, J12.4, J12.20, R27.2, R33.2, R35.2, R77.1, R88.1, SW1.1, SW2.1, T34.1, U1.1 (GND), U1.40 (GND), U1.41 (GND), U2.2 (GND), U6.1 (GND), U9.1 (A0), U9.2 (A1), U9.3 (A2), U9.4 (GND), U9.7 (WP), U15.1 (GND), U17.1 (GND)
unnamed: D1.2 (A), R1.2
unnamed: D2.2 (A), R2.2
unnamed: D17.2 (A), R20.2
unnamed: D18.2 (A2), J4.A4 (VBUS), J4.A9 (VBUS), J4.B4 (VBUS), J4.B9 (VBUS), L2.2
unnamed: J4.A5 (CC1), R35.1
unnamed: J4.B5 (CC2), R27.1
unnamed: C31.1, J4.S1 (SHIELD)
unnamed: J12.21, R31.1
unnamed: J12.22, R30.1
unnamed: J12.23, R32.1
unnamed: J12.24, R36.1
unnamed: C26.2, C71.1, C72.1, C73.1, L1.2, R51.1, R52.1, U1.2 (3V3)
unnamed: R33.1, U1.3 (EN), U6.2 (~RESET)
unnamed: SW2.2, U1.27 (IO0)
unnamed: C63.1, R86.2, T13.1, U2.1 (EN), U2.4 (VIN), U15.2 (VOUT), U15.7 (VOUT)
unnamed: R76.1, R77.2, U2.5 (FB)
unnamed: L14.1, U2.3 (SW)
unnamed: SW1.2, U6.3 (~MR)
unnamed: R87.1, R88.2, U15.4 (PR1)
unnamed: R86.1, U15.8 (ST)
VD3V3: C14.2, C39.2, C64.1, C65.1, J9.4, J12.3, L1.1, L14.2, R76.2, T33.1, U6.4 (VCC), U9.8 (VCC), U17.2 (VCC)

Notes on the sheet:
Status LEDs
RC Filter for analog signals
SSD1306 OLED
Debug and development connector for UART
Switchover to supply logic from USB for programming
EEPROM (parameter storage)
Sub-Board connector
ESP32-S3 main microcontroller and WiFi interface
USB programming interface
Reset controller
5V->3.3V DC/DC

Board: 2 copper layers, 274 parts (2 on the bottom side), 169 nets, no tracks yet.
