mcmaier/hodor/(commit log)

2025-02-21 Initial Kicad files
    [hodor_hardware.kicad_pcb, hodor_hardware.kicad_sch]
2025-02-21 Initial schematic - WIP!
    [controller.kicad_sch, hodor_hardware.kicad_sch, motor_control.kicad_sch, peripherals.kicad_sch, power_terminals.kicad_sch]
2025-02-24 Schematic finished
    [controller.kicad_sch, hodor_hardware.kicad_pcb, hodor_hardware.kicad_sch, motor_control.kicad_sch, peripherals.kicad_sch, power_terminals.kicad_sch]
2025-02-25 Added USB switchover function for 5V
    [controller.kicad_sch, hodor_hardware.kicad_pcb, peripherals.kicad_sch, power_terminals.kicad_sch]
2025-02-26 Reworked into 2 PCBs
    [449-340-55.STEP, SMH-104-02-G-S.stp, SSD1306_OLED.step, TSM-104-01-L-SH--3DModel-STEP-56544.STEP, TSM-104-01-L-SH.step, apra_Rail_DB4.DXF, controller.kicad_sch, hodor_hardware.kicad_pcb]
2025-02-27 Finished schematic - DRC ok.
    [hodor_hardware.kicad_sch]
2025-02-27 Finished schematic and initial placement on PCB
    [controller.kicad_sch, hodor_hardware.kicad_pcb, motor_control.kicad_sch, peripherals.kicad_sch, power_terminals.kicad_sch]
2025-02-27 Initialized SW project
    [hodor_hardware.kicad_pcb, peripherals.kicad_sch]
2025-03-13 Latest changes
    [controller.kicad_sch, hodor_hardware.kicad_pcb, motor_control.kicad_sch, power_terminals.kicad_sch]
2026-03-25 Split into submodules
    [449-340-55.STEP, SMH-104-02-G-S.stp, SSD1306_OLED.step, TSM-104-01-L-SH--3DModel-STEP-56544.STEP, TSM-104-01-L-SH.step, apra_Rail_DB4.DXF, controller.kicad_sch, hodor_hardware.kicad_pcb]
