mcmaier/hodor/(notices)

Notices in the files:
hodor_hardware/mechanics/SMH-104-02-G-S.stp:
author */ ('License CC BY-ND 4.0'),
